MaBaTa/Advanced-Servo-Controller/README.md

# Advanced-Servo-Controller

::: warn
Software not finished jet

:::
