MaBaTa/Advanced-Servo-Controller/Requirements.md

### Bauteile:

- ATtiny412

- DRV8231A

mg996r max ratings **2200mA at 7.4V at standstill**

### Folgende Features sind geplant:

FB der Position
FB des Motorstroms
Sanftlauf mit Beschleunigungskurven
Kompatibilität zu OneWire
UPDI Update
ggf.
I²C
Free Mode
Überstrom vermeidung

### Kompatibel mit:

Mechanisch Kompatibel mit MG90S daher auch MG996R & MG92S

Leistungskompatibel mit MG996R (Max 3,5A)
