MaBaTa/Advanced-Servo-Controller/Pictures/image-2025-05-30-002704.png

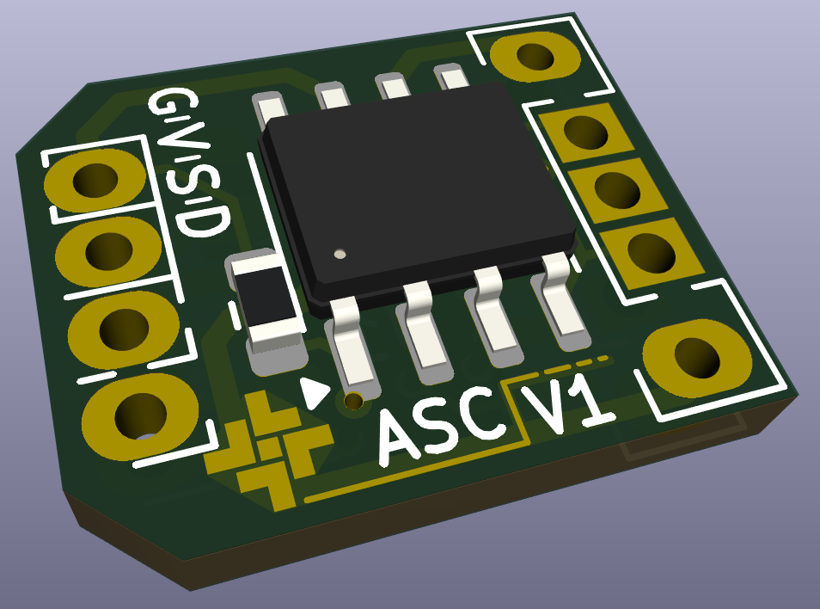
Pictures/image-2025-05-30-002704.png
