MaBaTa/Advanced-Servo-Controller/Pictures/image-2025-05-30-003628.png

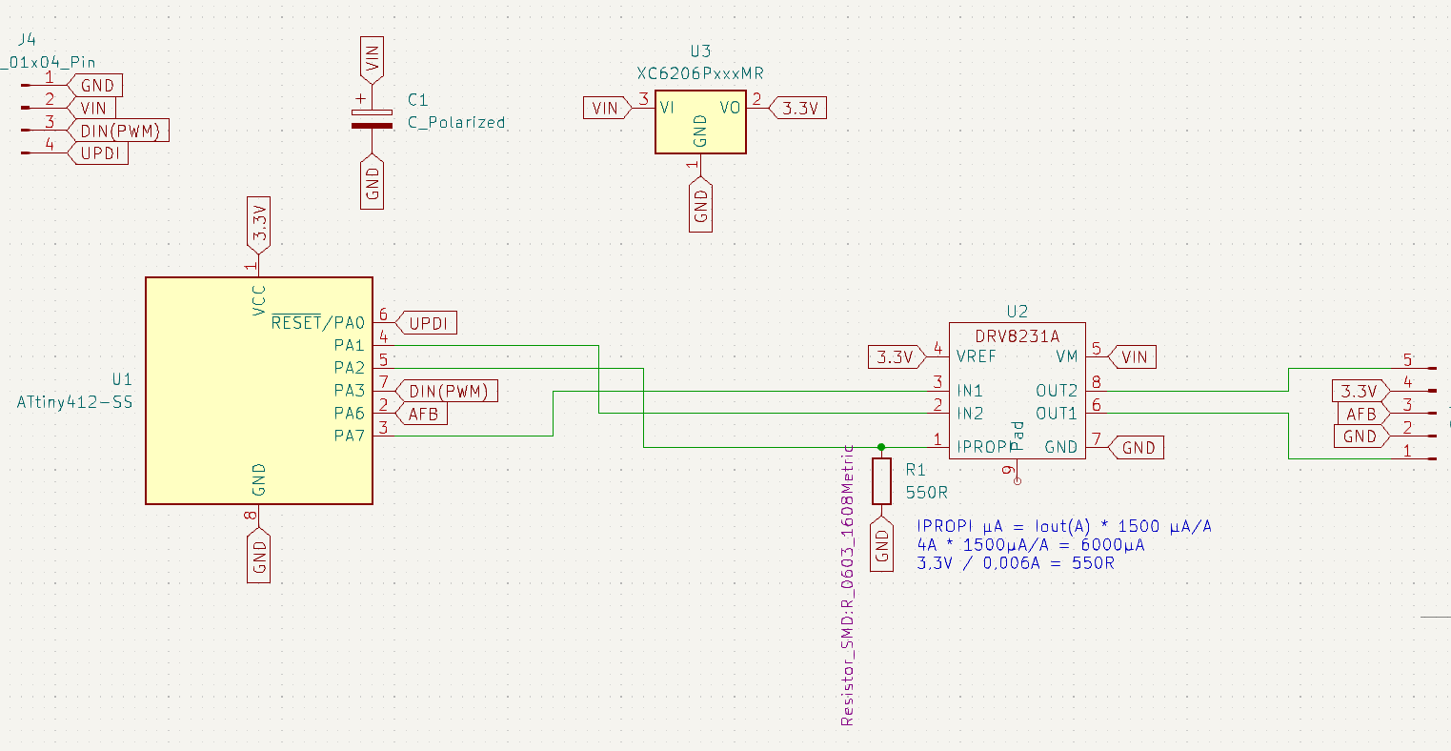
Pictures/image-2025-05-30-003628.png
