MaBaTa/Advanced-Servo-Controller/Pictures/IMG_20250611_174526700.jpg

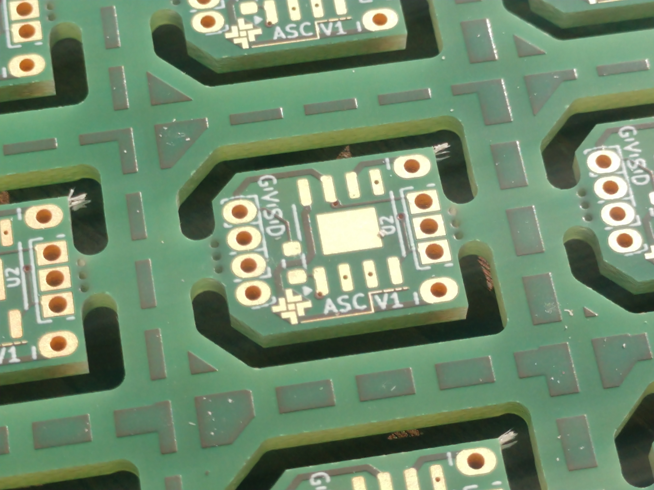
Pictures/IMG_20250611_174526700.jpg
