MaBaTa/Advanced-Servo-Controller/Pictures/IMG_20250611_174532711.jpg

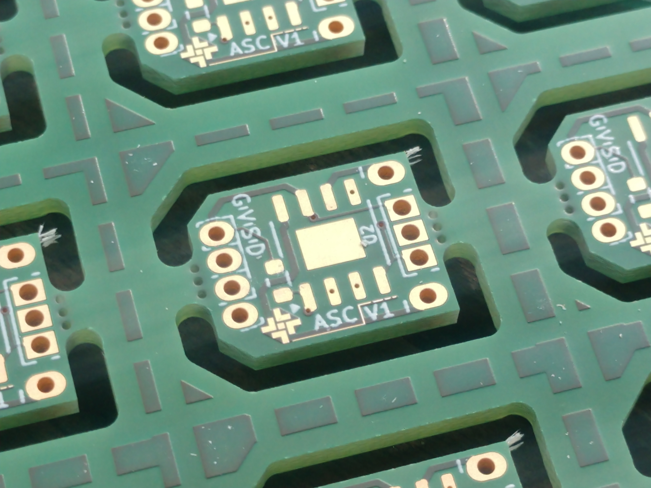
Pictures/IMG_20250611_174532711.jpg
