MaBaTa/Advanced-Servo-Controller/Pictures/IMG_20250611_181245520.jpg

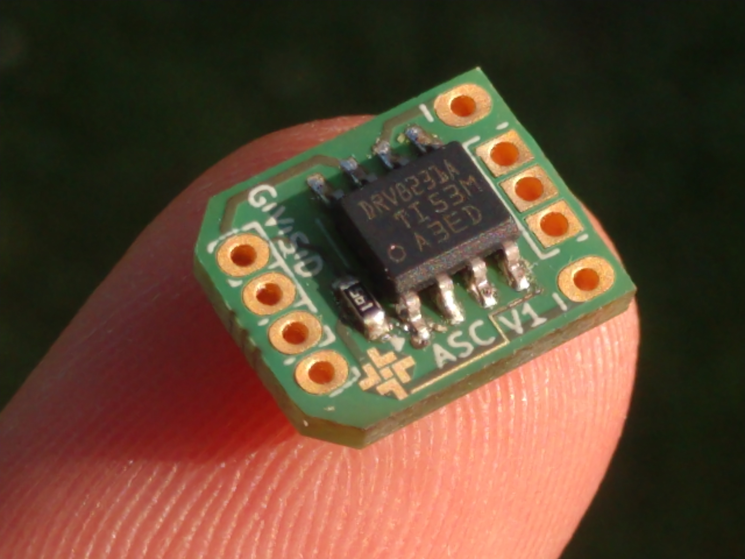
Pictures/IMG_20250611_181245520.jpg
