MaBaTa/Advanced-Servo-Controller/Pictures/IMG_20250611_181306513.jpg

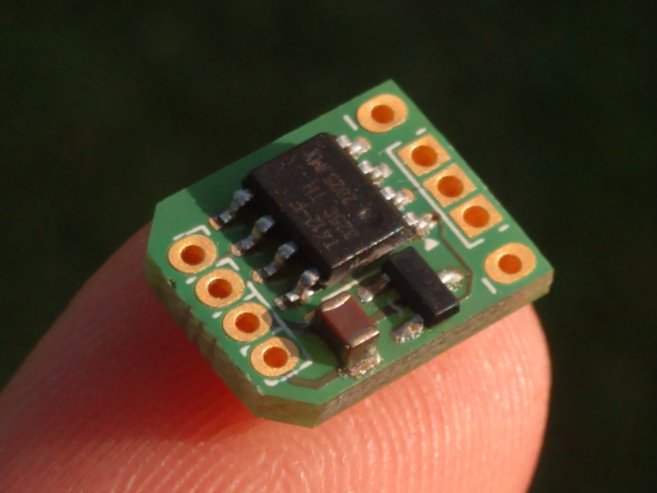
Pictures/IMG_20250611_181306513.jpg
