MaBaTa/Advanced-Servo-Controller/Pictures/IMG_20250611_181603267.jpg

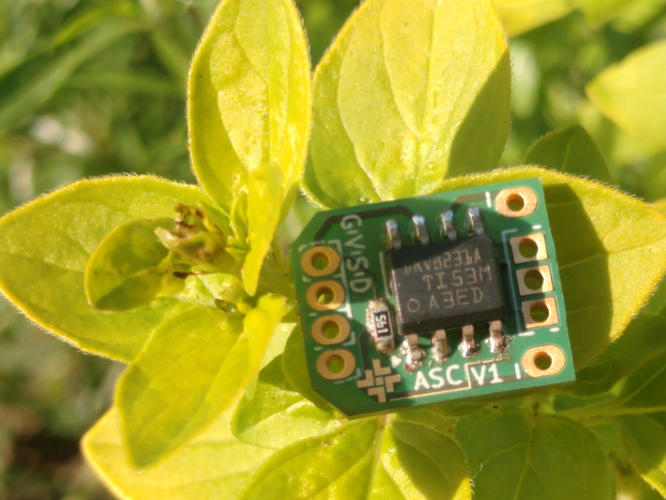
Pictures/IMG_20250611_181603267.jpg
