MaBaTa/Advanced-Servo-Controller/Pictures/IMG_20250611_182007673.jpg

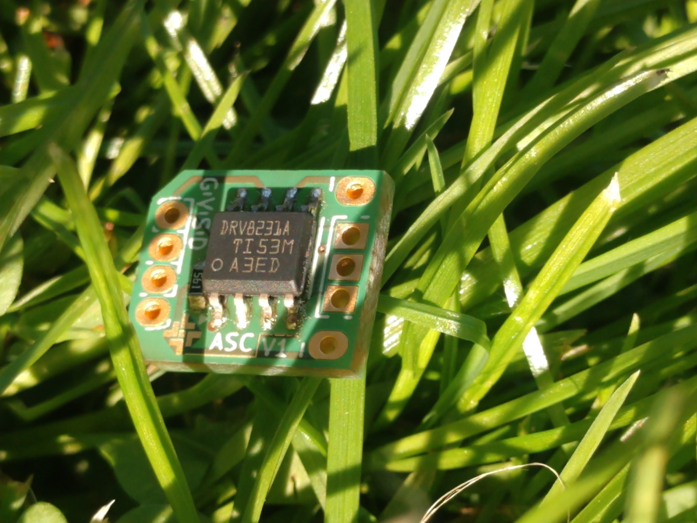
Pictures/IMG_20250611_182007673.jpg
