MaBaTa/Advanced-Servo-Controller/Pictures/IMG_20250611_182616874.jpg

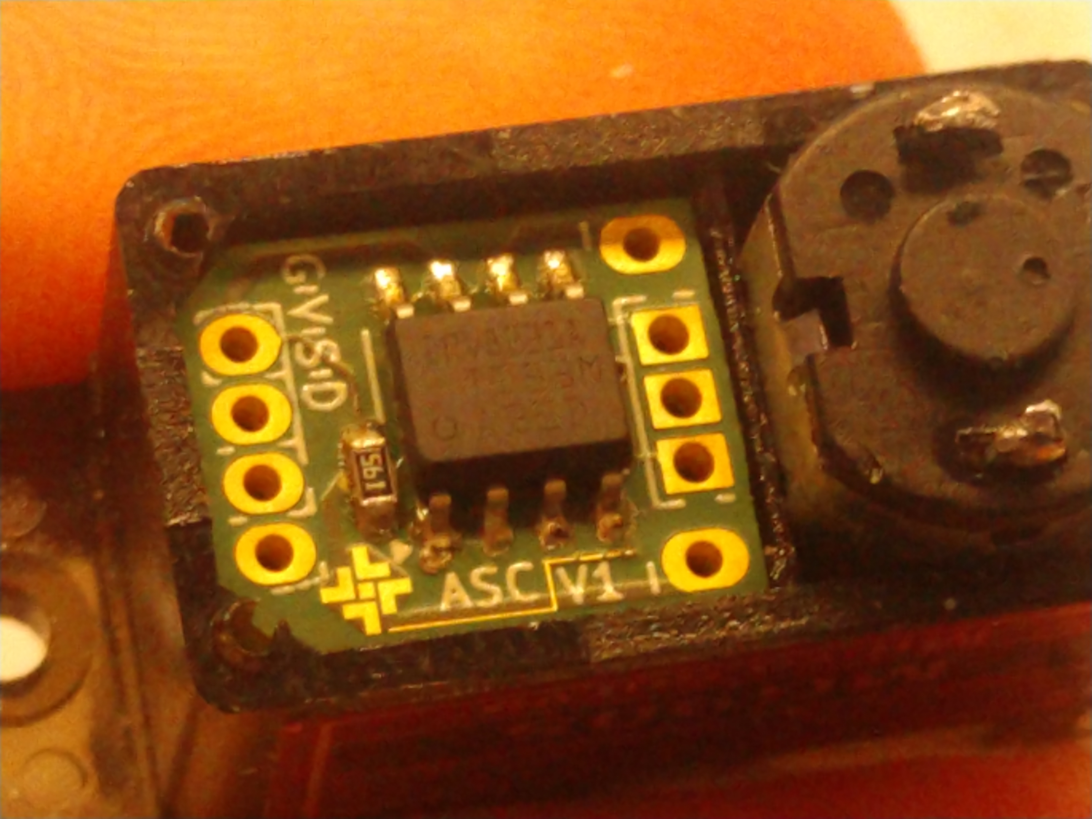
Pictures/IMG_20250611_182616874.jpg
