MaBaTa/Advanced-Servo-Controller/Pictures/IMG_20250611_190633895.jpg

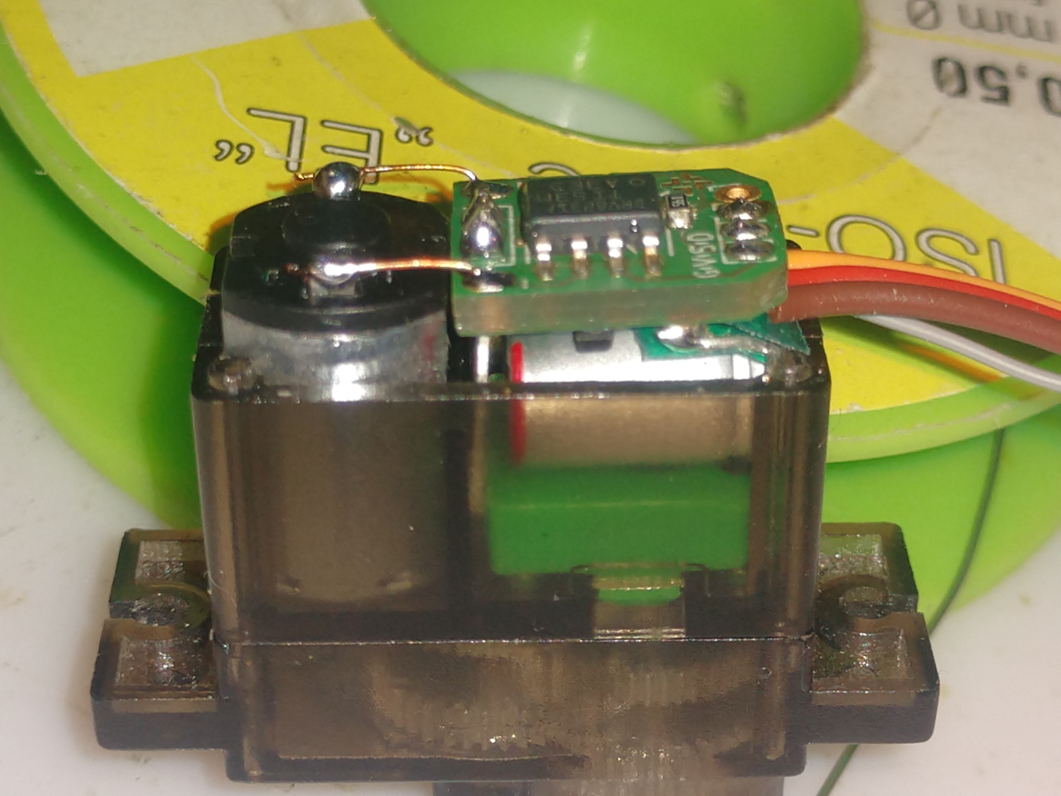
Pictures/IMG_20250611_190633895.jpg
