MaBaTa/Advanced-Servo-Controller/Pictures/IMG_20250611_190942698.jpg

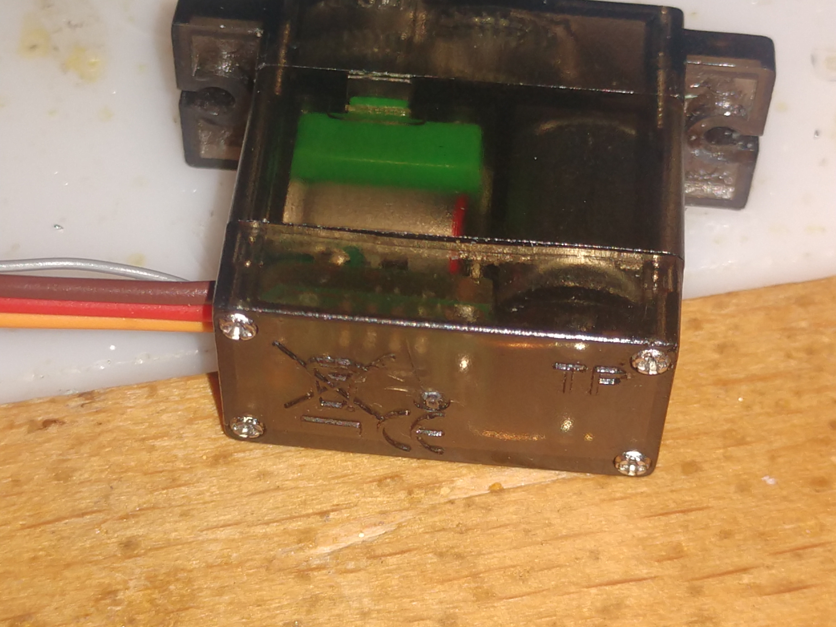
Pictures/IMG_20250611_190942698.jpg
