MaBaTa/Advanced-Servo-Controller/Pictures/IMG_20250611_190949079.jpg

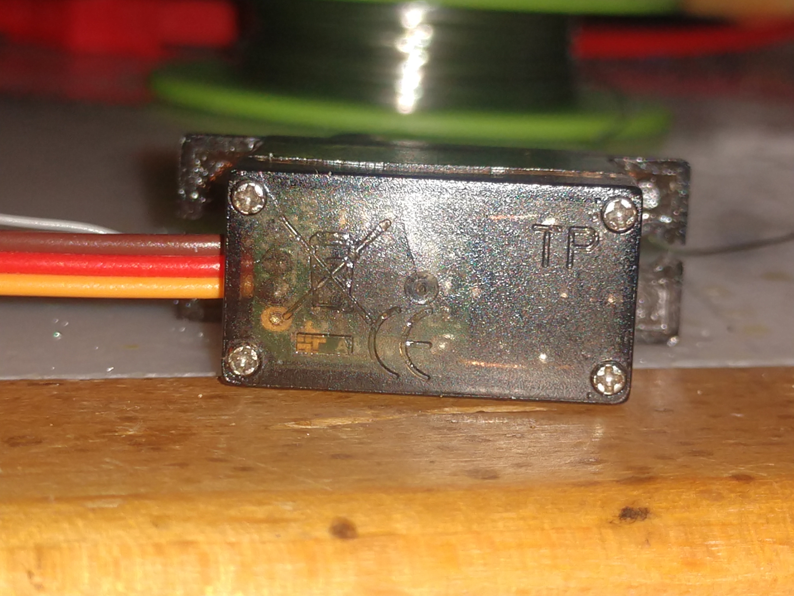
Pictures/IMG_20250611_190949079.jpg
