MaBaTa/Advanced-Servo-Controller/Pictures/IMG_20250611_190956626.jpg

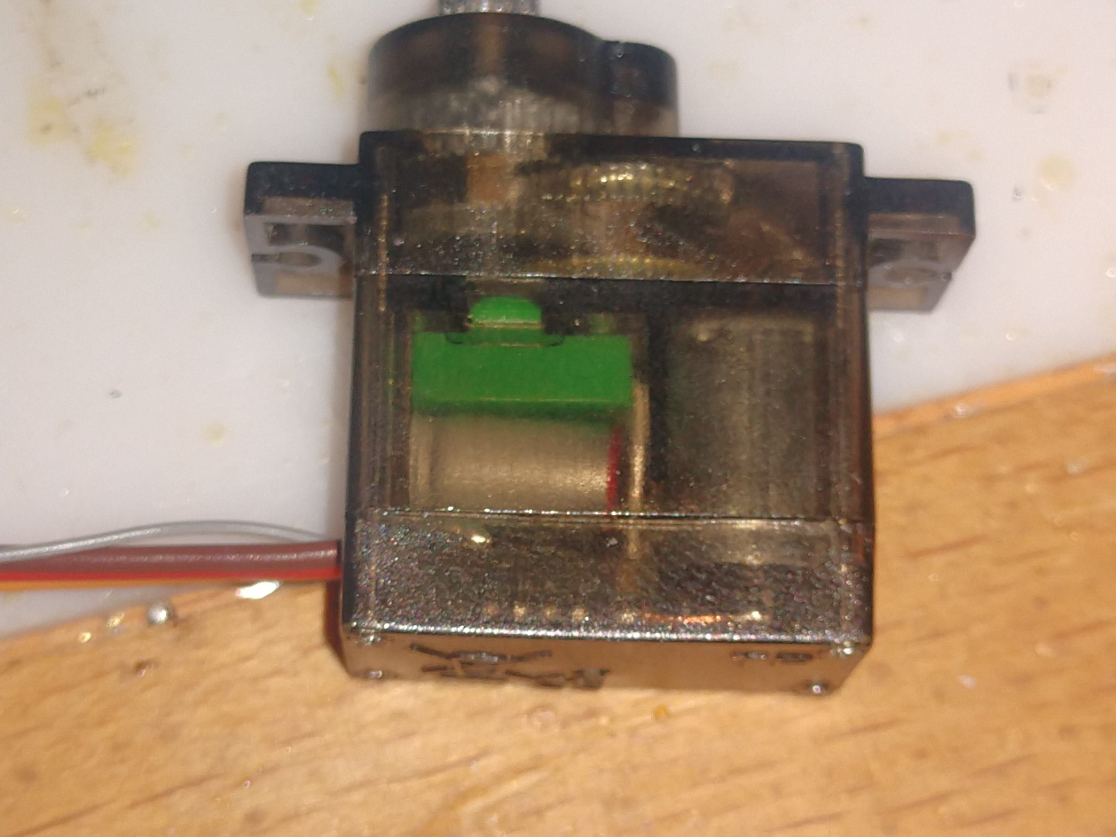
Pictures/IMG_20250611_190956626.jpg
