MaBaTa/Advanced-Servo-Controller/Servo Driver Board/PCB Top.png

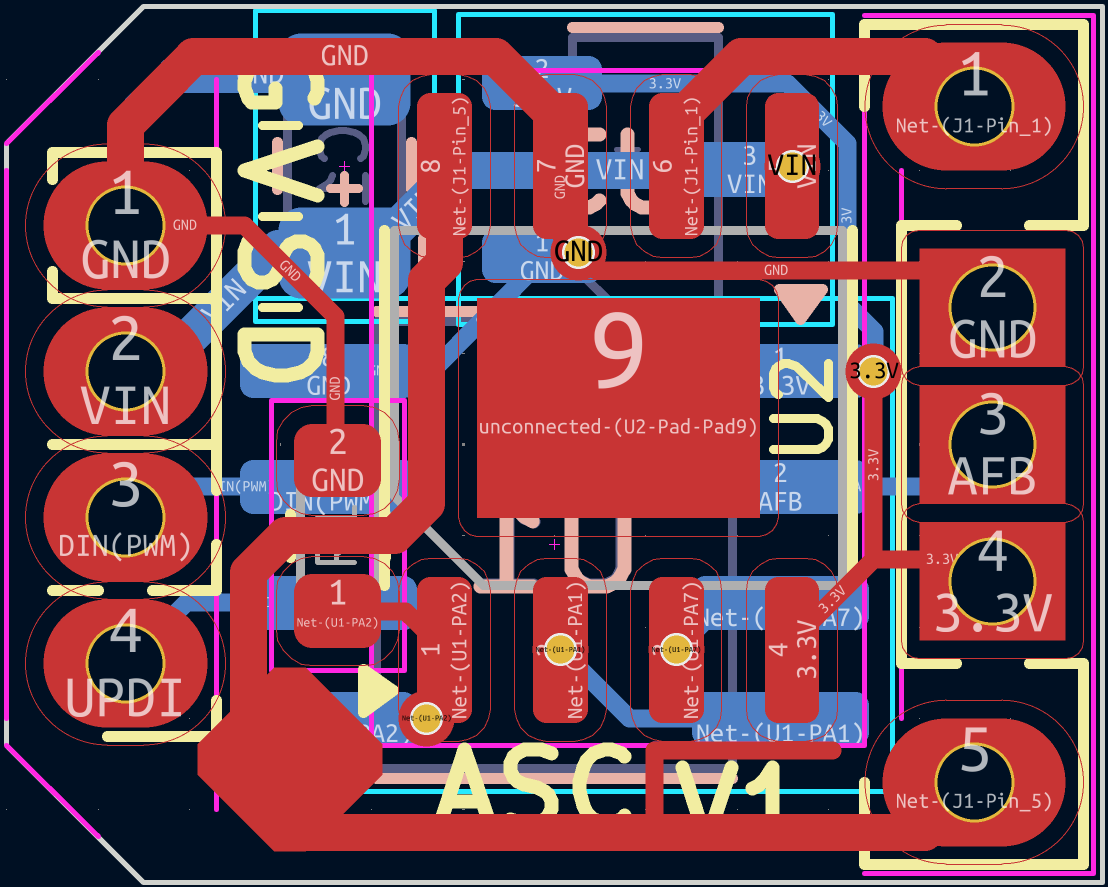
Servo Driver Board/PCB Top.png
