MaBaTa/Advanced-Servo-Controller/Servo Driver Board/Servo Driver Board.pdf

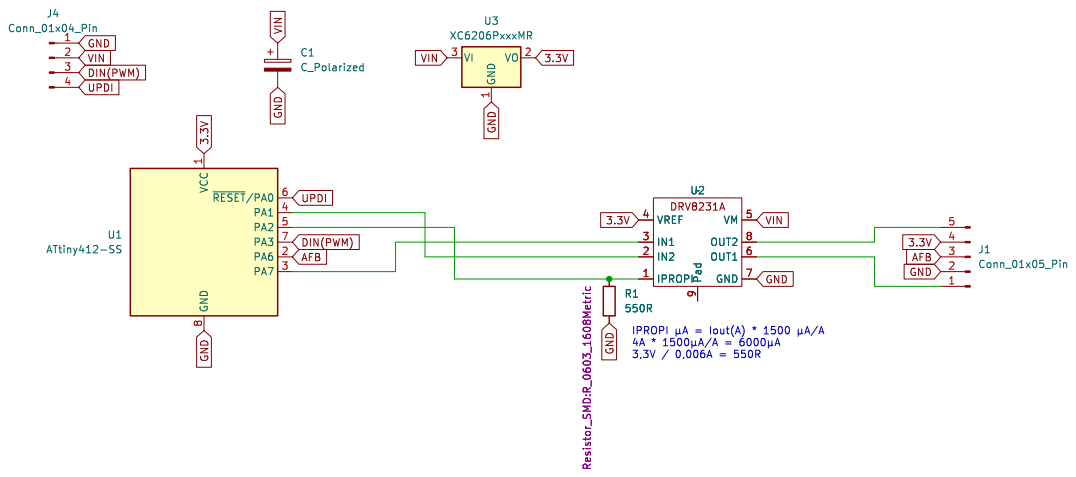
[picture p15: page 1]

IPROPI þÿ¼A= Iout(A) * 1500 þÿ¼A/A
