MaBaTa/Advanced-Servo-Controller/Servo Driver Board/Servo Driver Board.kicad_pcb

## KiCad design Servo Driver Board/Servo Driver Board.kicad_pcb (2025-06-02)

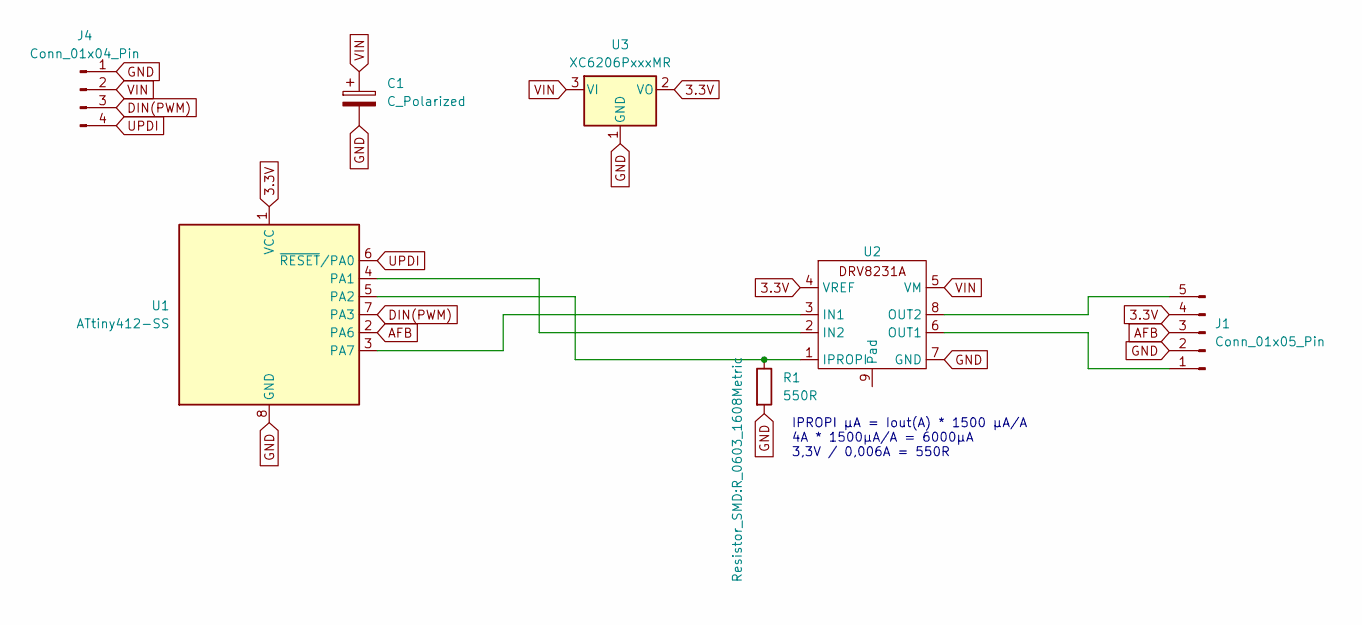
[picture p16: schematic Servo Driver Board.kicad_sch]

Parts:
C1: C_Polarized; C_0805_2012Metric
J1: Conn_01x05_Pin; PinHeader_1x05_P1.27mm_Vertical
J4: Conn_01x04_Pin; PinHeader_1x04_P1.27mm_Vertical
R1: 550R; R_0603_1608Metric
U1: ATtiny412-SS; SOIC-8_3.9x4.9mm_P1.27mm
U2: HSOP-8-1EP_3.9x4.9mm_P1.27mm_EP2.41x3.1mm
U3: XC6206PxxxMR; SOT-23-3

Connections:
3.3V: J1.4, U1.1 (VCC), U2.4 (VREF), U3.2 (VO)
AFB: J1.3, U1.2 (PA6)
DIN(PWM): J4.3, U1.7 (PA3)
GND: C1.2, J1.2, J4.1, R1.2, U1.8 (GND), U2.7 (GND), U3.1 (GND)
unnamed: J1.1, U2.6 (OUT1)
unnamed: J1.5, U2.8 (OUT2)
unnamed: U1.4 (PA1), U2.2 (IN2)
unnamed: R1.1, U1.5 (PA2), U2.1 (IPROPI)
unnamed: U1.3 (PA7), U2.3 (IN1)
UPDI: J4.4, U1.6 (~RESET/PA0)
VIN: C1.1, J4.2, U2.5 (VM), U3.3 (VI)

Notes on the sheet:
IPROPI μA = Iout(A) * 1500 μA/A 4A * 1500μA/A = 6000μA 3,3V / 0,006A = 550R

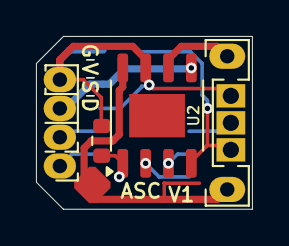
[picture p17: board Servo Driver Board.kicad_pcb from above]

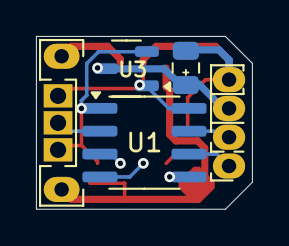
[picture p18: board Servo Driver Board.kicad_pcb from below]

Board: 2 copper layers, 12.0 x 9.6 mm, 7 parts (3 on the bottom side), 11 nets.
