MaBaTa/Advanced-Servo-Controller/Usage in Proxxon Micromot/pictures/IMG_20260315_013107583.jpg

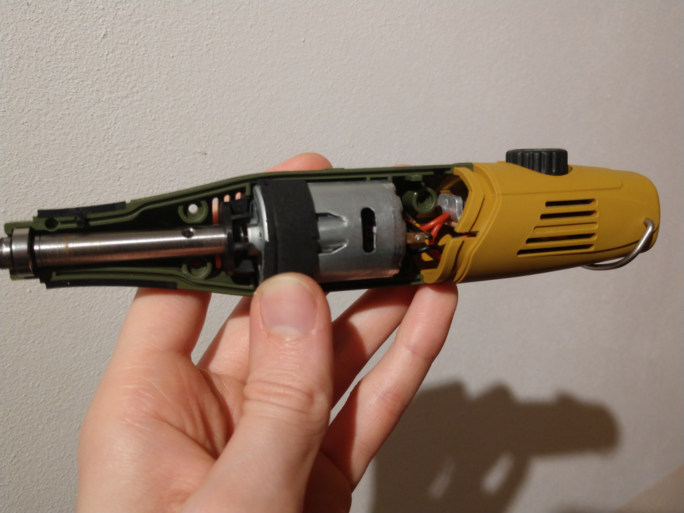
Usage in Proxxon Micromot/pictures/IMG_20260315_013107583.jpg
