MaBaTa/Advanced-Servo-Controller/(commit log)

2025-11-15 Init Air Pump
2026-01-29 Schego Air Pump spelling improved
2026-03-15 PID Experiments
